enkhbold470/pd-brick/media/bottom.png

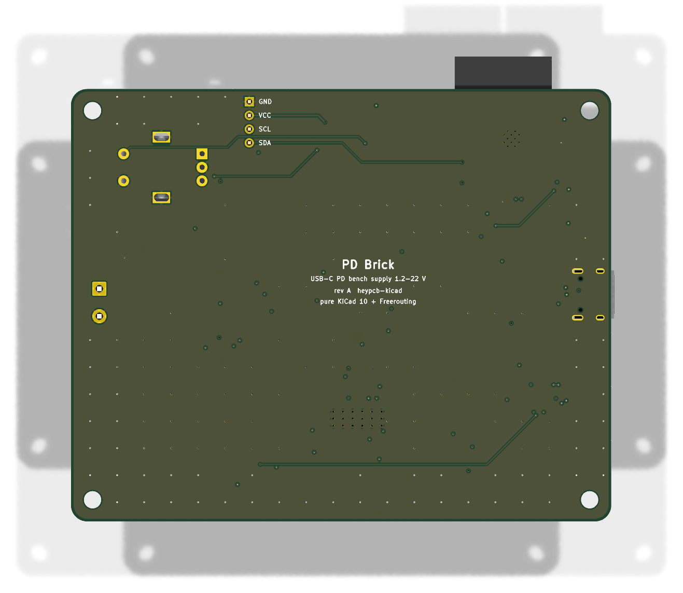
media/bottom.png
