enkhbold470/pd-brick/media/top.png

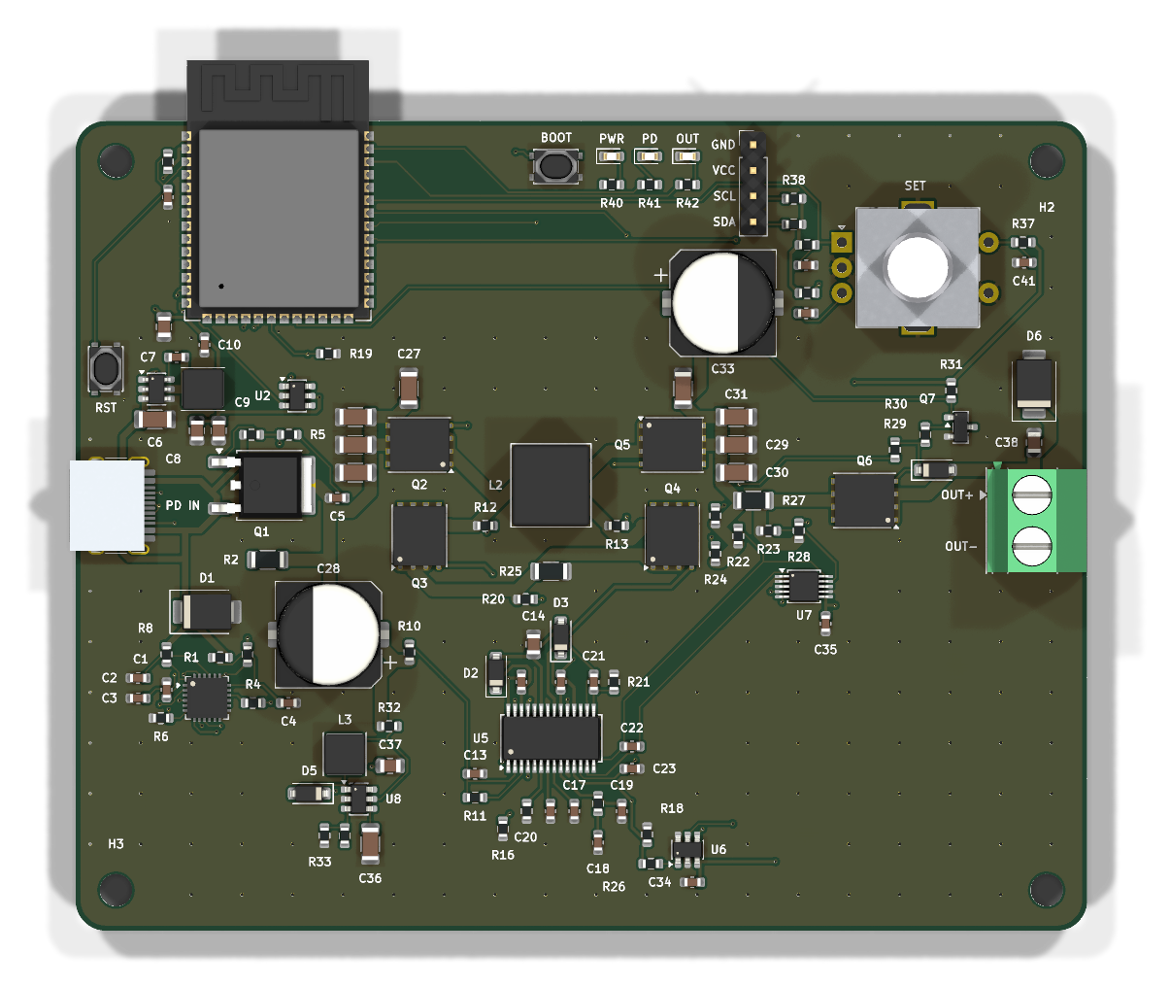
media/top.png
