enkhbold470/pd-brick/fab/pd_brick.step

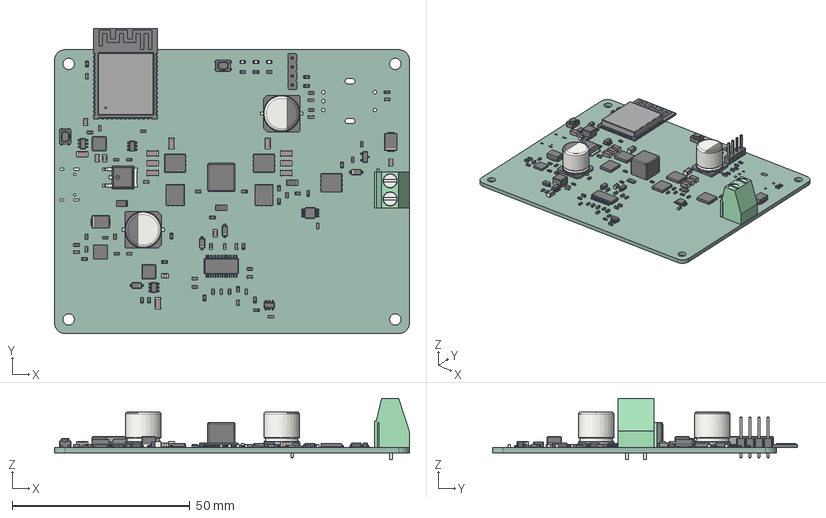
[picture p5: CAD file, 2026-10-02]
fab/pd_brick.step
100.0 x 86.0 x 17.3 mm
R_0603_1608Metric x 39
C_1206_3216Metric x 10
C_0603_1608Metric x 23
TDSON_8_1 x 5
SOT-23
QFN-24-1EP_4x4mm_P0.5mm_EP2.7x2.7mm
SOT-23-6 x 3
D_SOD-123 x 4
SW_SPST_PTS810 x 2
L_Changjiang_FNR4030S
TerminalBlock_Phoenix_MKDS-1,5-2-5.08_1x02_P5.08mm_Horizontal
TSOT-23-6
D_SMB x 2
LED_0603_1608Metric x 3
C_0805_2012Metric x 6
TSSOP-10_3x3mm_P0.5mm
932d09b3-9c39-11ed-93f0-dde97e994e83_part
932d09b4-9c39-11ed-93f0-dde97e994e83_part
932d09b5-9c39-11ed-93f0-dde97e994e83_part
PinHeader_1x04_P254mm_Vertical
CP_Elec_10x10 x 2
L_Coilcraft_XAL7070-XXX
R_1206_3216Metric x 3
ESP32-S3-WROOM-1
HTSSOP-28-1EP_4.4x9.7mm_P0.65mm_EP3.4x9.5mm
a68460a4-8551-11ed-a139-00155d22e2d7_part
a684622a-8551-11ed-a139-00155d22e2d7_part
a68462b6-8551-11ed-a139-00155d22e2d7_part
pd_brick_PCB
