enkhbold470/pd-brick/fab/pd_brick_schematic.pdf

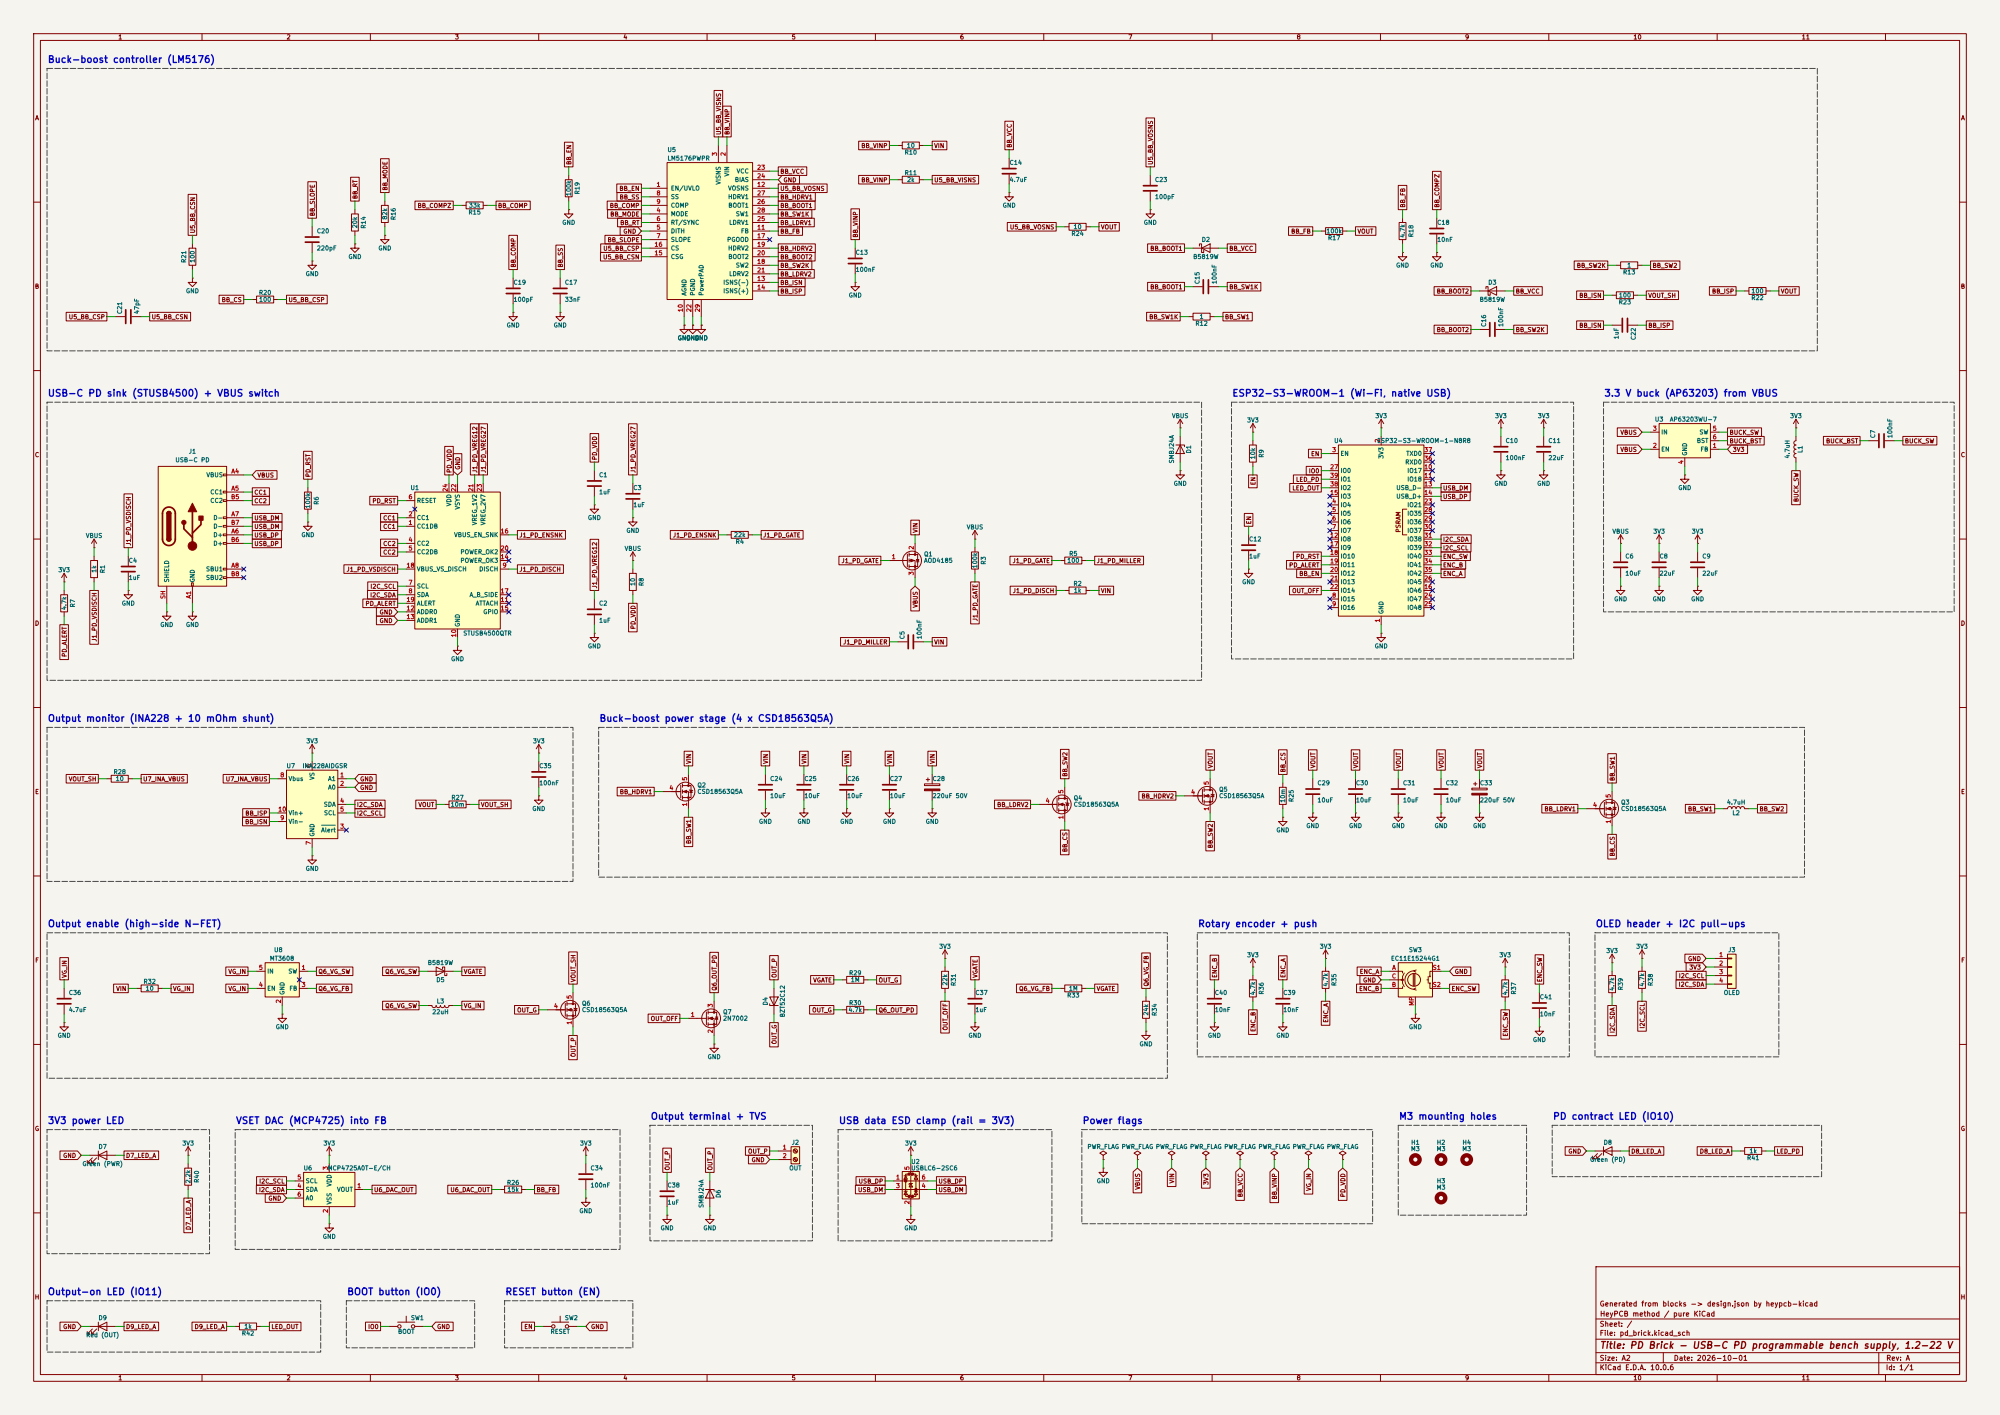
[picture p6: page 1]

3 MODE 4 DITH 5 RT/SYNC 6

PD_ALERT USB-C PD sink (STUSB4500) + VBUS switch

ESP32-S3-WROOM-1 (Wi-Fi, native USB)

Output monitor (INA228 + 10 mOhm shunt)

Buck-boost power stage (4 x CSD18563Q5A)

Output enable (high-side N-FET)

OLED header + I2C pull-ups
I2C_SDA D8_LED_A

USB data ESD clamp (rail = 3V3)

Generated from blocks -> design.json by heypcb-kicad
HeyPCB method / pure KiCad
Sheet: /
File: pd_brick.kicad_sch
Title: PD Brick - USB-C PD programmable bench supply, 1.2-22 V

Size: A2 | Rev: A
KiCad E.D.A. 10.0.6 | Id: 1/1
