enkhbold470/pd-brick/kicad/pd_brick.kicad_pcb

## KiCad design kicad/pd_brick.kicad_pcb (2026-10-02)

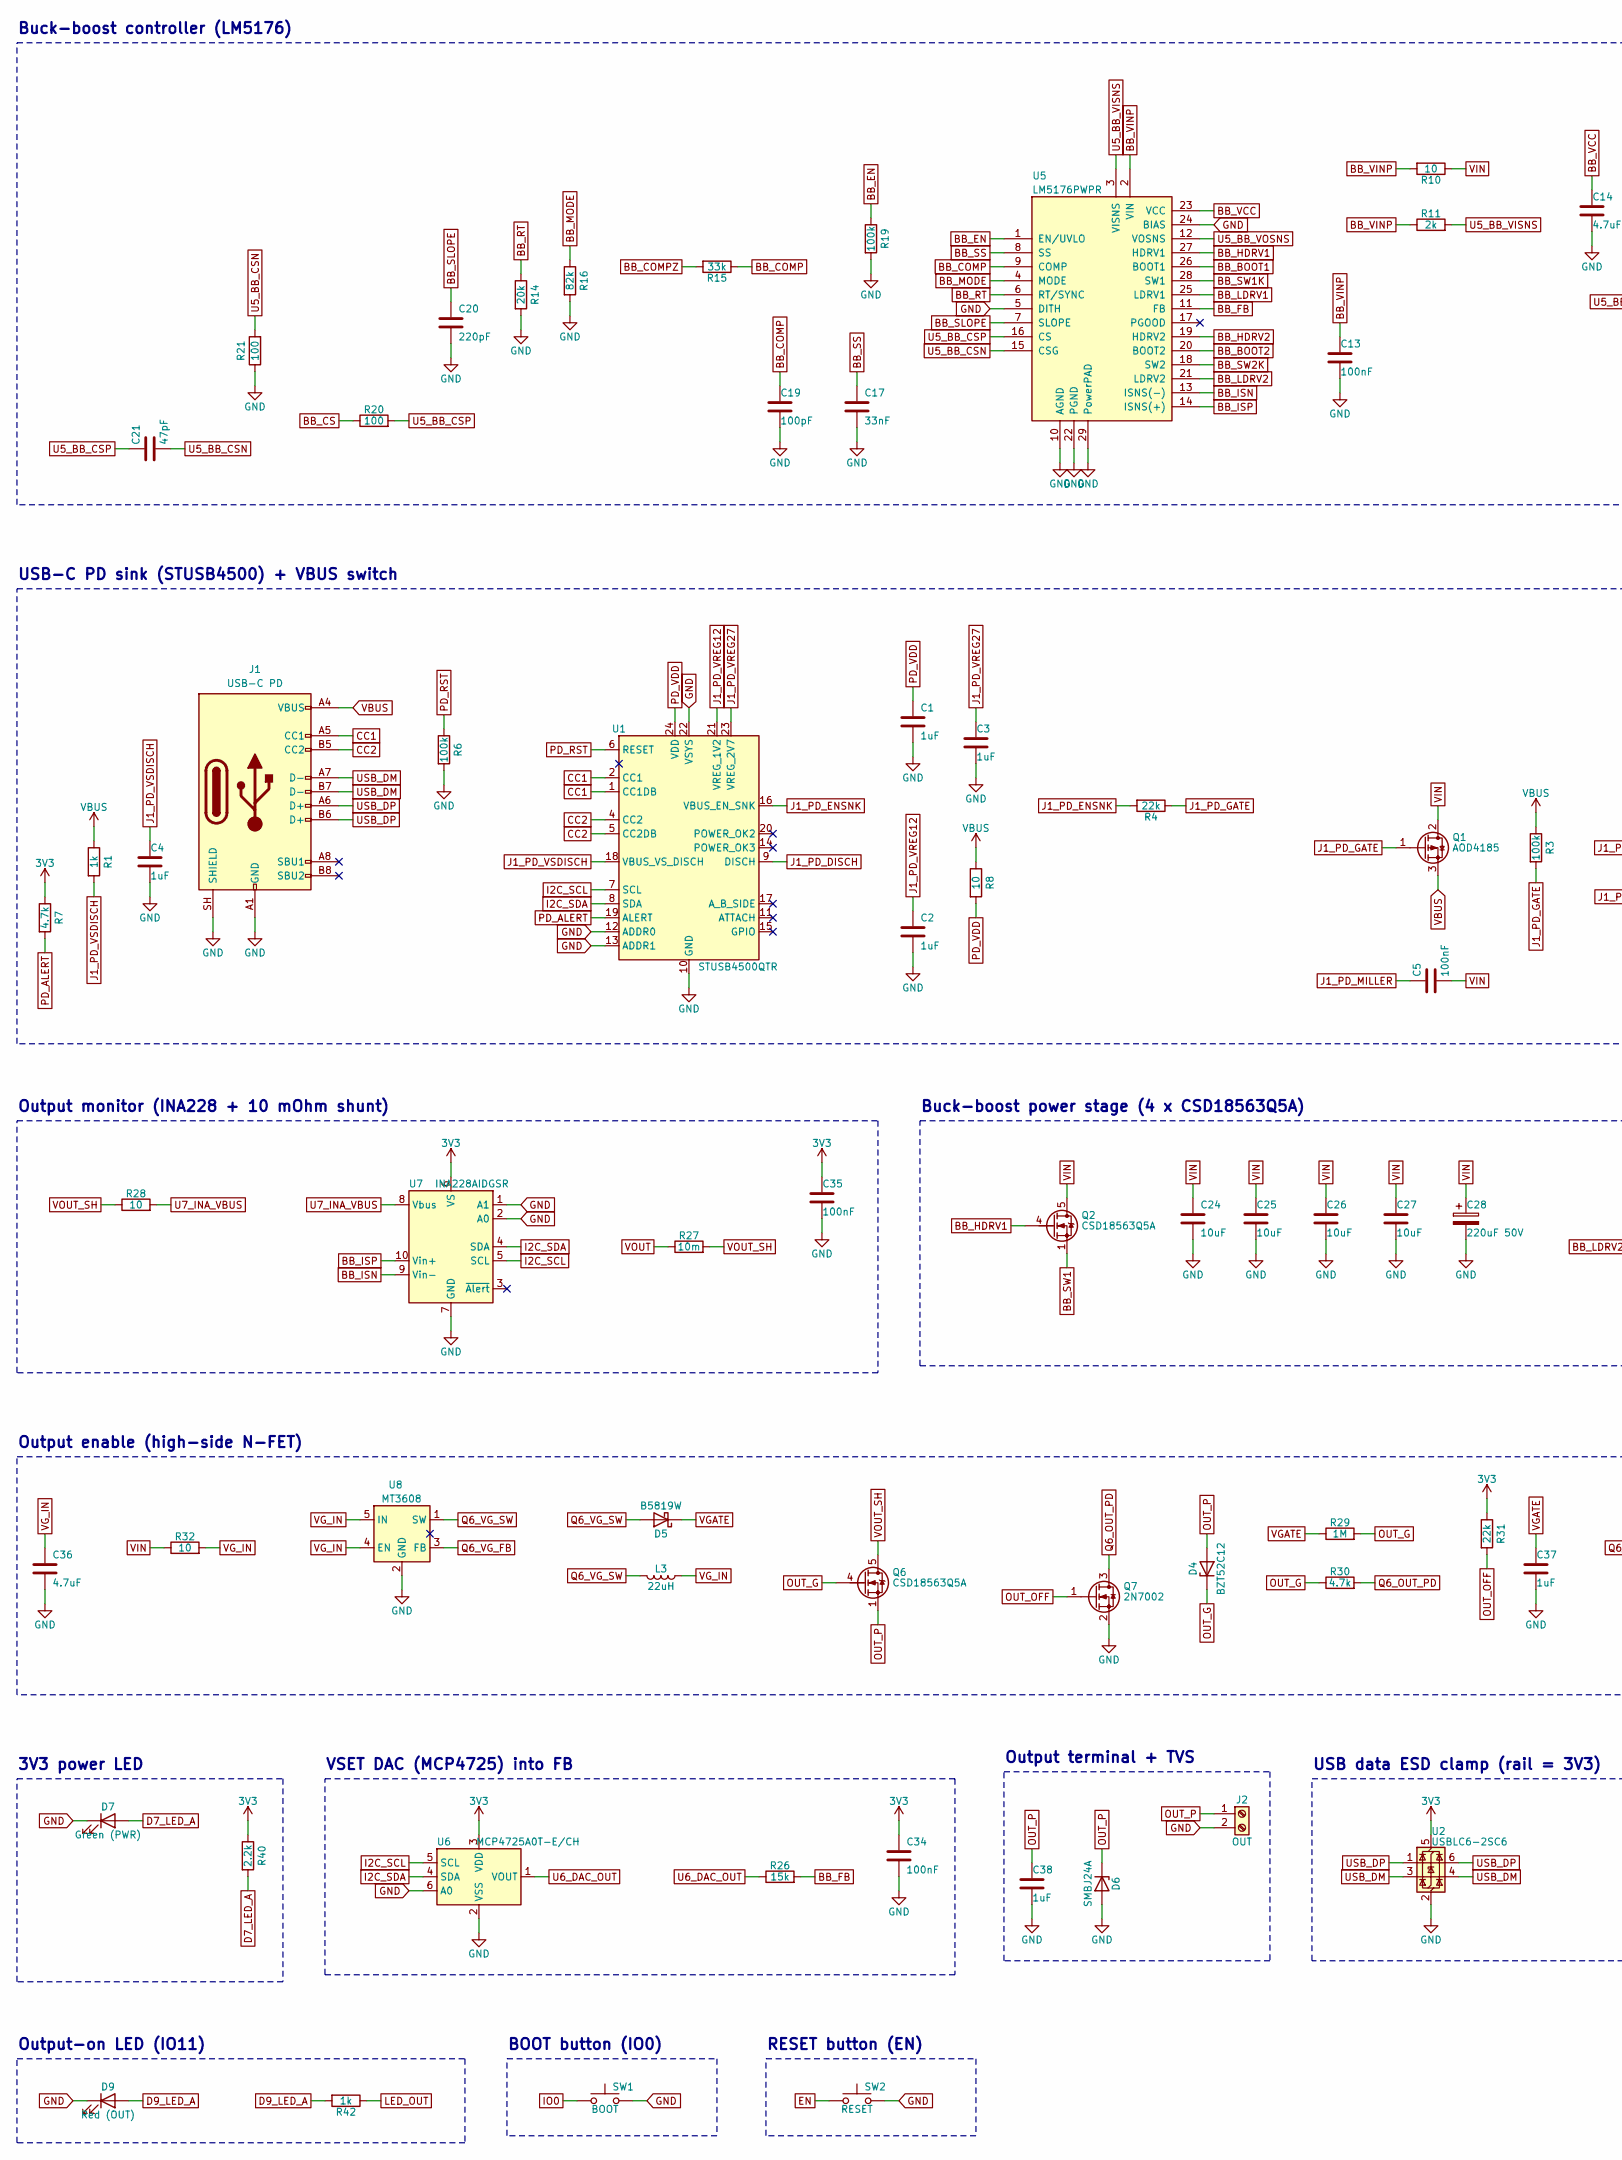
[picture p7: schematic pd_brick.kicad_sch, PD Brick - USB-C PD programmable bench supply, 1.2-22 V, part in row 1, column 1]

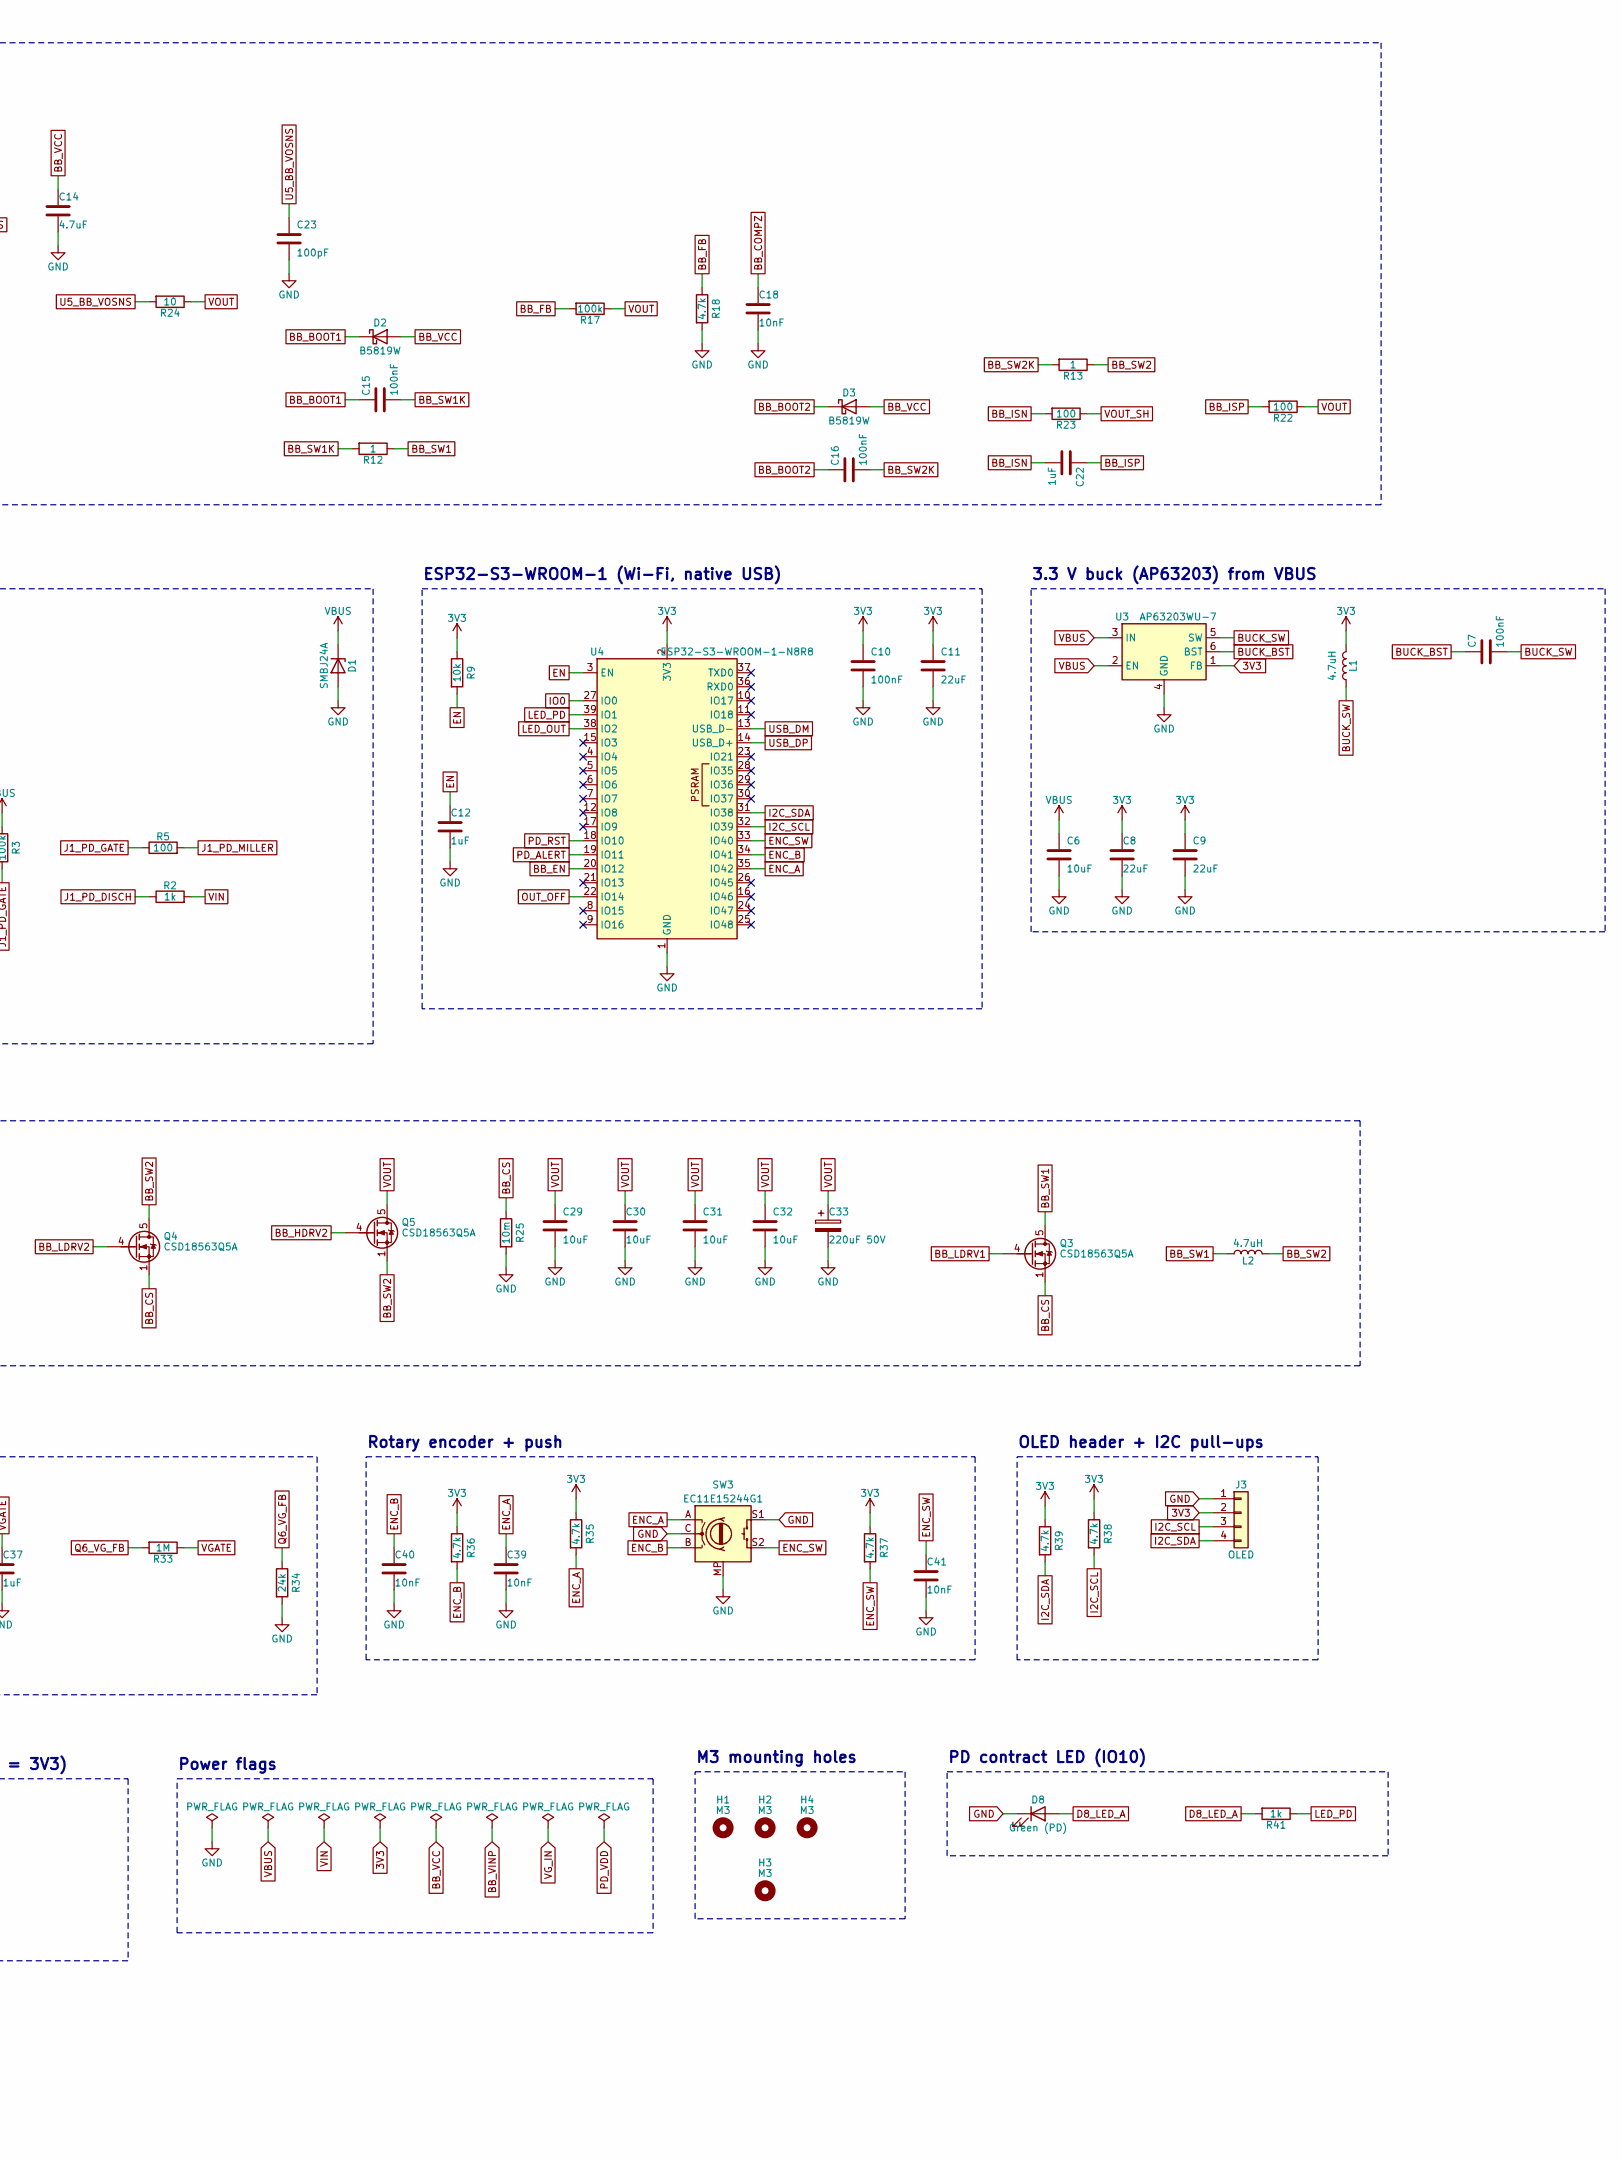
[picture p8: schematic pd_brick.kicad_sch, PD Brick - USB-C PD programmable bench supply, 1.2-22 V, part in row 1, column 2]

Parts:
C1, C2, C3, C4, C12, C22: 1uF; C_0603_1608Metric; MPN CL10A105KB8NNNC; LCSC C15849
C5, C7, C10, C13, C15, C16, C34, C35: 100nF; C_0603_1608Metric; MPN CC0603KRX7R9BB104; LCSC C14663
C6, C24, C25, C26, C27, C29, C30, C31, C32: 10uF; C_1206_3216Metric; MPN CL31A106KBHNNNE; LCSC C13585
C8, C9, C11: 22uF; C_0805_2012Metric; MPN CL21A226MAQNNNE; LCSC C45783
C14: 4.7uF; C_0805_2012Metric; MPN CL21A475KAQNNNE; LCSC C1779
C17: 33nF; C_0603_1608Metric; MPN CL10B333KB8NNNC; LCSC C21117
C18, C39, C40, C41: 10nF; C_0603_1608Metric; MPN 0603B103K500NT; LCSC C57112
C19, C23: 100pF; C_0603_1608Metric; MPN CL10C101JB8NNNC; LCSC C14858
C20: 220pF; C_0603_1608Metric; MPN CL10B221KB8NNNC; LCSC C1603
C21: 47pF; C_0603_1608Metric; MPN CL10C470JB8NNNC; LCSC C1671
C28, C33: 220uF 50V; CP_Elec_10x10; MPN MA50V220M10x10; LCSC C46550473
C36: 4.7uF; C_1206_3216Metric; MPN 1206B475K500NT; LCSC C29823
C37, C38: 1uF; C_0805_2012Metric; MPN CL21B105KBFNNNE; LCSC C28323
D1, D6: SMBJ24A; D_SMB; MPN SMBJ24A; LCSC C123819
D2, D3, D5: B5819W; D_SOD-123; MPN B5819W SL; LCSC C8598
D4: BZT52C12; D_SOD-123; MPN BZT52C12; LCSC C173429
D7: Green (PWR); LED_0603_1608Metric; MPN KT-0603G; LCSC C12624
D8: Green (PD); LED_0603_1608Metric; MPN KT-0603G; LCSC C12624
D9: Red (OUT); LED_0603_1608Metric; MPN KT-0603R; LCSC C2286
H1, H2, H3, H4: M3; MountingHole_3.2mm_M3
J1: USB-C PD; USB_C_Receptacle_HRO_TYPE-C-31-M-12; MPN TYPE-C-31-M-12; LCSC C165948
J2: OUT; TerminalBlock_Phoenix_MKDS-1,5-2-5.08_1x02_P5.08mm_Horizont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; MPN MKDS 1,5/ 2-5,08; LCSC C5183929
J3: OLED; PinHeader_1x04_P2.54mm_Vertical; MPN PZ254V-11-04P; LCSC C2691448
L1: 4.7uH; L_Sunlord_SWPA4030S; MPN SWPA4030S4R7MT; LCSC C57269
L2: 4.7uH; L_Coilcraft_XAL7070-XXX; MPN XAL7070-472MEC; LCSC C3911513
L3: 22uH; L_Changjiang_FNR4030S; MPN FNR4030S220MT; LCSC C167883
Q1: AOD4185; TO-252-2; MPN AOD4185; LCSC C400894
Q2, Q3, Q4, Q5, Q6: CSD18563Q5A; TDSON-8-1; MPN CSD18563Q5A; LCSC C77239
Q7: 2N7002; SOT-23; MPN 2N7002; LCSC C8545
R1, R41, R42: 1k; R_0603_1608Metric; MPN 0603WAF1001T5E; LCSC C21190
R2: 1k; R_1206_3216Metric; MPN 1206W4F1001T5E; LCSC C4410
R3, R6, R17, R19: 100k; R_0603_1608Metric; MPN 0603WAF1003T5E; LCSC C25803
R4, R31: 22k; R_0603_1608Metric; MPN 0603WAF2202T5E; LCSC C31850
R5, R20, R21, R22, R23: 100; R_0603_1608Metric; MPN 0603WAF1000T5E; LCSC C22775
R7, R18, R30, R35, R36, R37, R38, R39: 4.7k; R_0603_1608Metric; MPN 0603WAF4701T5E; LCSC C23162
R8, R10, R24, R28, R32: 10; R_0603_1608Metric; MPN 0603WAF100JT5E; LCSC C22859
R9: 10k; R_0603_1608Metric; MPN 0603WAF1002T5E; LCSC C25804
R11: 2k; R_0603_1608Metric; MPN 0603WAF2001T5E; LCSC C22975
R12, R13: 1; R_0603_1608Metric; MPN 0603WAF100KT5E; LCSC C22936
R14: 20k; R_0603_1608Metric; MPN 0603WAF2002T5E; LCSC C4184
R15: 33k; R_0603_1608Metric; MPN 0603WAF3302T5E; LCSC C4216
R16: 82k; R_0603_1608Metric; MPN 0603WAF8202T5E; LCSC C23254
R25, R27: 10m; R_1206_3216Metric; MPN FMF06FTHR010-LH; LCSC C105362
R26: 15k; R_0603_1608Metric; MPN 0603WAF1502T5E; LCSC C22809
R29, R33: 1M; R_0603_1608Metric; MPN 0603WAF1004T5E; LCSC C22935
R34: 24k; R_0603_1608Metric; MPN 0603WAF2402T5E; LCSC C23352
R40: 2.2k; R_0603_1608Metric; MPN 0603WAF2201T5E; LCSC C4190
SW1: BOOT; SW_SPST_PTS810; MPN PTS810SJM250SMTRLFS; LCSC C116501
SW2: RESET; SW_SPST_PTS810; MPN PTS810SJM250SMTRLFS; LCSC C116501
SW3: EC11E15244G1; RotaryEncoder_Alps_EC11E-Switch_Vertical_H20mm; MPN EC11E15244G1; LCSC C370970
U1: STUSB4500QTR; QFN-24-1EP_4x4mm_P0.5mm_EP2.7x2.7mm; MPN STUSB4500QTR; LCSC C2678061
U2: USBLC6-2SC6; SOT-23-6; MPN USBLC6-2SC6; LCSC C7519
U3: AP63203WU-7; TSOT-23-6; MPN AP63203WU-7; LCSC C780769
U4: ESP32-S3-WROOM-1-N8R8; ESP32-S3-WROOM-1; MPN ESP32-S3-WROOM-1-N8R8; LCSC C2913201
U5: LM5176PWPR; HTSSOP-28-1EP_4.4x9.7mm_P0.65mm_EP3.4x9.5mm_ThermalVias; MPN LM5176PWPR; LCSC C442493
U6: MCP4725A0T-E/CH; SOT-23-6; MPN MCP4725A0T-E/CH; LCSC C144198
U7: INA228AIDGSR; TSSOP-10_3x3mm_P0.5mm; MPN INA228AIDGSR; LCSC C2887910
U8: MT3608; SOT-23-6; MPN MT3608; LCSC C84817

Connections:
3V3: C8.1, C9.1, C10.1, C11.1, C34.1, C35.1, J3.2, L1.2, R7.1, R9.1, R31.1, R35.1, R36.1, R37.1, R38.1, R39.1, R40.1, U2.5 (VBUS), U3.1 (FB), U4.2 (3V3), U6.3 (VDD), U7.6 (VS)
BB_BOOT1: C15.1, D2.1 (K), U5.26 (BOOT1)
BB_BOOT2: C16.1, D3.1 (K), U5.20 (BOOT2)
BB_COMP: C19.1, R15.1, U5.9 (COMP)
BB_COMPZ: C18.1, R15.2
BB_CS: Q3.1 (S), Q3.2 (S), Q3.3 (S), Q4.1 (S), Q4.2 (S), Q4.3 (S), R20.1, R25.1
BB_EN: R19.1, U4.20 (IO12), U5.1 (EN/UVLO)
BB_FB: R17.2, R18.1, R26.2, U5.11 (FB)
BB_HDRV1: Q2.4 (G), U5.27 (HDRV1)
BB_HDRV2: Q5.4 (G), U5.19 (HDRV2)
BB_ISN: C22.2, R23.2, U5.13 (ISNS(-)), U7.9 (Vin-)
BB_ISP: C22.1, R22.2, U5.14 (ISNS(+)), U7.10 (Vin+)
BB_LDRV1: Q3.4 (G), U5.25 (LDRV1)
BB_LDRV2: Q4.4 (G), U5.21 (LDRV2)
BB_MODE: R16.1, U5.4 (MODE)
BB_RT: R14.1, U5.6 (RT/SYNC)
BB_SLOPE: C20.1, U5.7 (SLOPE)
BB_SS: C17.1, U5.8 (SS)
BB_SW1: L2.1, Q2.1 (S), Q2.2 (S), Q2.3 (S), Q3.5 (D), R12.1
BB_SW1K: C15.2, R12.2, U5.28 (SW1)
BB_SW2: L2.2, Q4.5 (D), Q5.1 (S), Q5.2 (S), Q5.3 (S), R13.1
BB_SW2K: C16.2, R13.2, U5.18 (SW2)
BB_VCC: C14.1, D2.2 (A), D3.2 (A), U5.23 (VCC)
BB_VINP: C13.1, R10.2, R11.1, U5.2 (VIN)
BUCK_BST: C7.1, U3.6 (BST)
BUCK_SW: C7.2, L1.1, U3.5 (SW)
CC1: J1.A5 (CC1), U1.1 (CC1DB), U1.2 (CC1)
CC2: J1.B5 (CC2), U1.4 (CC2), U1.5 (CC2DB)
D7_LED_A: D7.2 (A), R40.2
D8_LED_A: D8.2 (A), R41.2
D9_LED_A: D9.2 (A), R42.2
EN: C12.1, R9.2, SW2.1, U4.3 (EN)
ENC_A: C39.1, R35.2, SW3.A, U4.35 (IO42)
ENC_B: C40.1, R36.2, SW3.B, U4.34 (IO41)
ENC_SW: C41.1, R37.2, SW3.S2, U4.33 (IO40)
GND: C1.2, C2.2, C3.2, C4.2, C6.2, C8.2, C9.2, C10.2, C11.2, C12.2, C13.2, C14.2, C17.2, C18.2, C19.2, C20.2, C23.2, C24.2, C25.2, C26.2, C27.2, C28.2, C29.2, C30.2, C31.2, C32.2, C33.2, C34.2, C35.2, C36.2, C37.2, C38.2, C39.2, C40.2, C41.2, D1.2 (A), D6.2 (A), D7.1 (K), D8.1 (K), D9.1 (K), J1.A1 (GND), J1.A12 (GND), J1.B1 (GND), J1.B12 (GND), J1.SH (SHIELD), J2.2, J3.1, Q7.2 (S), R6.2, R14.2, R16.2, R18.2, R19.2, R21.1, R25.2, R34.2, SW1.2, SW2.2, SW3.C, SW3.MP, SW3.S1, U1.10 (GND), U1.12 (ADDR0), U1.13 (ADDR1), U1.22 (VSYS), U1.25 (GND), U2.2 (GND), U3.4 (GND), U4.1 (GND), U4.40 (GND), U4.41 (GND), U5.5 (DITH), U5.10 (AGND), U5.22 (PGND), U5.24 (BIAS), U5.29 (PowerPAD), U6.2 (VSS), U6.6 (A0), U7.1 (A1), U7.2 (A0), U7.7 (GND), U8.2 (GND)
I2C_SCL: J3.3, R38.2, U1.7 (SCL), U4.32 (IO39), U6.5 (SCL), U7.5 (SCL)
I2C_SDA: J3.4, R39.2, U1.8 (SDA), U4.31 (IO38), U6.4 (SDA), U7.4 (SDA)
IO0: SW1.1, U4.27 (IO0)
J1_PD_DISCH: R2.1, U1.9 (DISCH)
J1_PD_ENSNK: R4.2, U1.16 (VBUS_EN_SNK)
J1_PD_GATE: Q1.1 (G), R3.2, R4.1, R5.1
J1_PD_MILLER: C5.1, R5.2
J1_PD_VREG12: C2.1, U1.21 (VREG_1V2)
J1_PD_VREG27: C3.1, U1.23 (VREG_2V7)
J1_PD_VSDISCH: C4.1, R1.2, U1.18 (VBUS_VS_DISCH)
LED_OUT: R42.1, U4.38 (IO2)
LED_PD: R41.1, U4.39 (IO1)
OUT_G: D4.1 (K), Q6.4 (G), R29.2, R30.1
OUT_OFF: Q7.1 (G), R31.2, U4.22 (IO14)
OUT_P: C38.1, D4.2 (A), D6.1 (K), J2.1, Q6.1 (S), Q6.2 (S), Q6.3 (S)
PD_ALERT: R7.2, U1.19 (ALERT), U4.19 (IO11)
PD_RST: R6.1, U1.6 (RESET), U4.18 (IO10)
PD_VDD: C1.1, R8.2, U1.24 (VDD)
Q6_OUT_PD: Q7.3 (D), R30.2
Q6_VG_FB: R33.2, R34.1, U8.3 (FB)
Q6_VG_SW: D5.2 (A), L3.2, U8.1 (SW)
U5_BB_CSN: C21.2, R21.2, U5.15 (CSG)
U5_BB_CSP: C21.1, R20.2, U5.16 (CS)
U5_BB_VISNS: R11.2, U5.3 (VISNS)
U5_BB_VOSNS: C23.1, R24.2, U5.12 (VOSNS)
U6_DAC_OUT: R26.1, U6.1 (VOUT)
U7_INA_VBUS: R28.2, U7.8 (Vbus)
USB_DM: J1.A7 (D-), J1.B7 (D-), U2.3 (I/O2), U2.4 (I/O2), U4.13 (USB_D-)
USB_DP: J1.A6 (D+), J1.B6 (D+), U2.1 (I/O1), U2.6 (I/O1), U4.14 (USB_D+)
VBUS: C6.1, D1.1 (K), J1.A4 (VBUS), J1.A9 (VBUS), J1.B4 (VBUS), J1.B9 (VBUS), Q1.3 (S), R1.1, R3.1, R8.1, U3.2 (EN), U3.3 (IN)
VGATE: C37.1, D5.1 (K), R29.1, R33.1
VG_IN: C36.1, L3.1, R32.2, U8.4 (EN), U8.5 (IN)
VIN: C5.2, C24.1, C25.1, C26.1, C27.1, C28.1, Q1.2 (D), Q2.5 (D), R2.2, R10.1, R32.1
VOUT: C29.1, C30.1, C31.1, C32.1, C33.1, Q5.5 (D), R17.1, R22.1, R24.1, R27.1
VOUT_SH: Q6.5 (D), R23.1, R27.2, R28.1

Notes on the sheet:
USB-C PD sink (STUSB4500) + VBUS switch
USB data ESD clamp (rail = 3V3)
3.3 V buck (AP63203) from VBUS
ESP32-S3-WROOM-1 (Wi-Fi, native USB)
BOOT button (IO0)
RESET button (EN)
Buck-boost controller (LM5176)
Buck-boost power stage (4 x CSD18563Q5A)
VSET DAC (MCP4725) into FB
Output monitor (INA228 + 10 mOhm shunt)
Output enable (high-side N-FET)
Output terminal + TVS
Rotary encoder + push
OLED header + I2C pull-ups
3V3 power LED
PD contract LED (IO10)
Output-on LED (IO11)
M3 mounting holes
Power flags

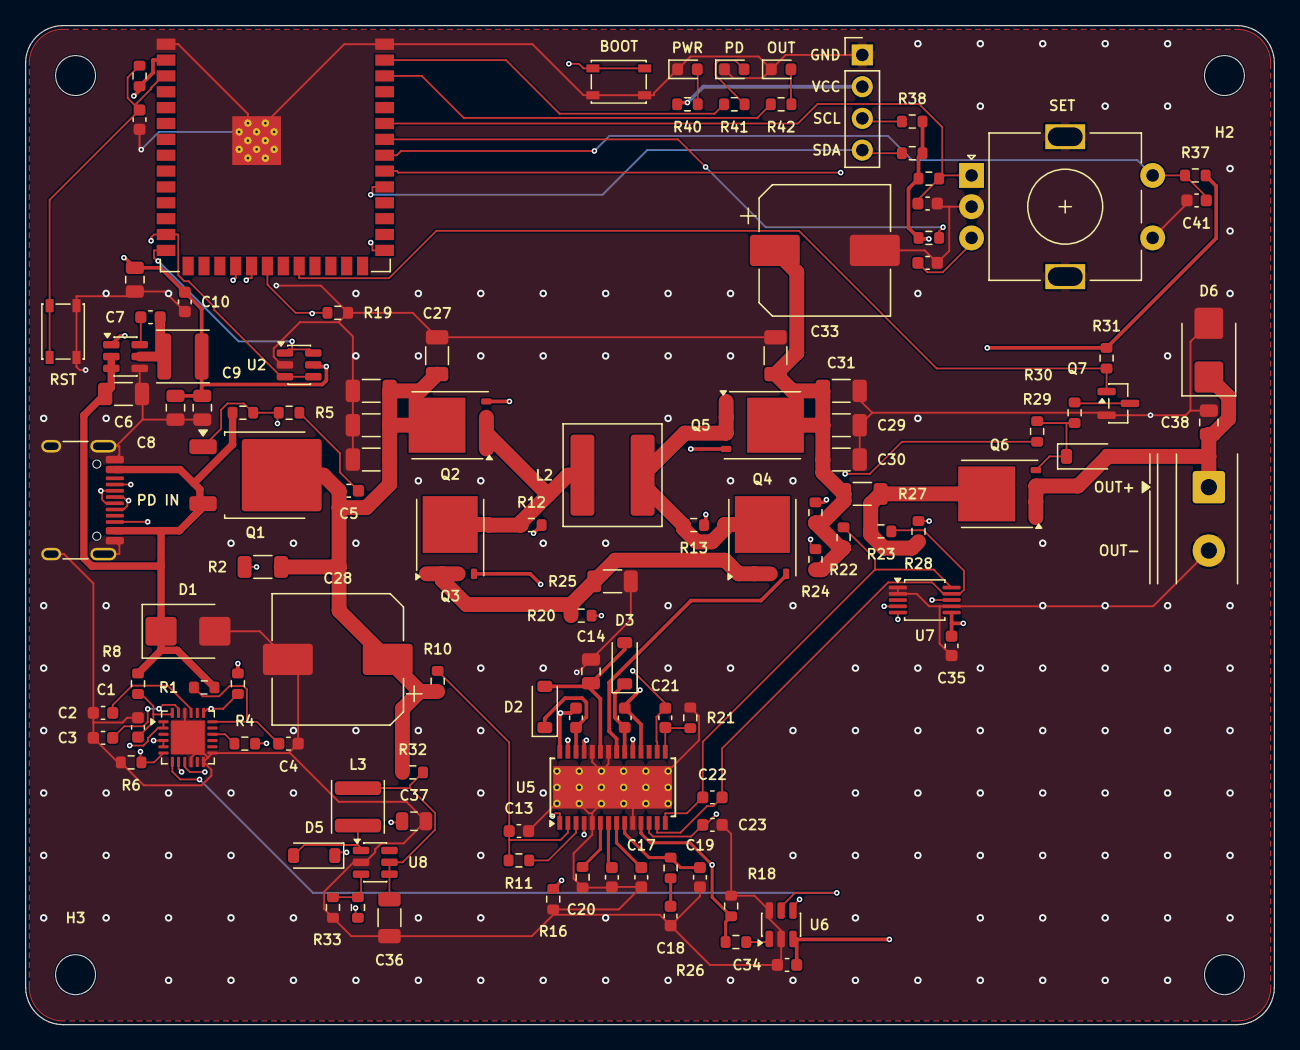
[picture p9: board pd_brick.kicad_pcb from above]

Board: 4 copper layers, 100.0 x 80.0 mm, 120 parts (0 on the bottom side), 71 nets.
